NCabbage/e203_cnn/py/my_digit.png

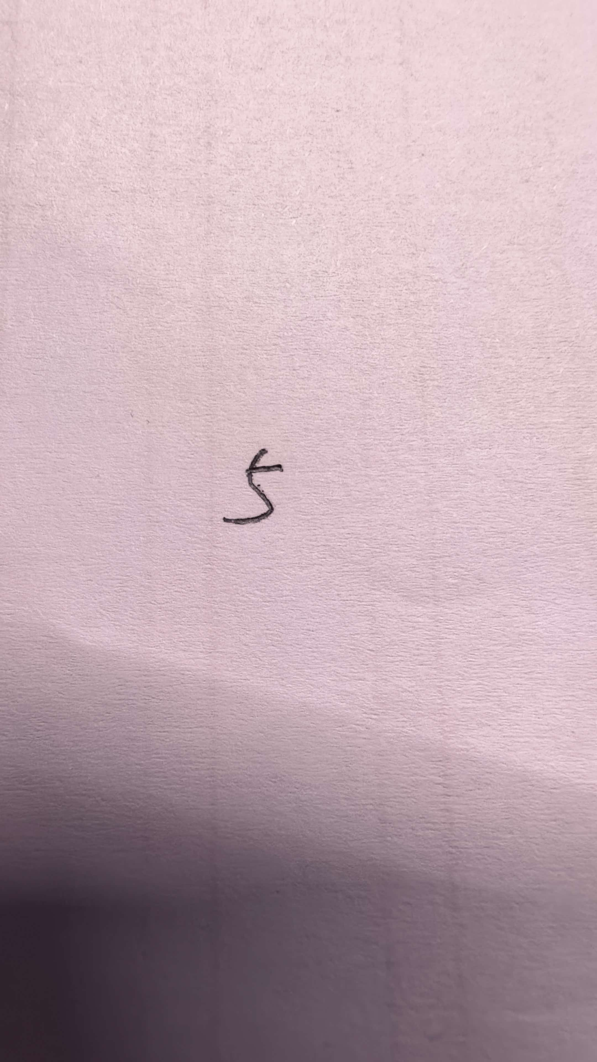
py/my_digit.png
