NCabbage/e203_cnn/测试数据/数据.docx

E203底座:

Coremark分数

HummingBird SDK Build Time: Sep 23 2026, 09:10:42

Download Mode: ILM

CPU Frequency 15936716 Hz

Start to run coremark for 500 iterations

2K performance run parameters for coremark.

CoreMark Size : 666

Total ticks : 236054487

Total time (secs): 14.812167

Iterations/Sec : 33.756034

Iterations : 500

Compiler version : GCC10.1.0

Compiler flags : -O2 -funroll-all-loops -finline-limit=600 -ftree-dominator-opts -fno-if-conversion2 -fselective-scheduling -fno-code-hoisting -fno-common -funroll-loops -finline-functions -falign-functions=4 -falign-jumps=4 -falign-loops=4

Memory location : STACK

seedcrc : 0xe9f5

[0]crclist : 0xe714

[0]crcmatrix : 0x1fd7

[0]crcstate : 0x8e3a

[0]crcfinal : 0xa14c

Correct operation validated. See readme.txt for run and reporting rules.

CoreMark 1.0 : 33.756034 / GCC10.1.0 -O2 -funroll-all-loops -finline-limit=600 -ftree-dominator-opts -fno-if-conversion2 -fselective-scheduling -fno-code-hoisting -fno-common -funroll-loops -finline-functions -falign-functions=4 -falign-jumps=4 -falign-loops=4 / STACK

Print Personal Added Addtional Info to Easy Visual Analysis

(Iterations is: 500

(total_ticks is: 236054487

(*) Assume the core running at 1 MHz

So the CoreMark/MHz can be caculated by:

(Iterations*1000000/total_ticks) = 2.118155 CoreMark/MHz

ICB桥

基线

PS端RAM核数据

耗时0.327ms

E203 跑纯C

===== Benchmark Result =====

Total cycles: 8040143

Total mul num: 282429

Total load num: 639234

Total store num: 66842

Total stall num: 499400

CPU Frequency: 15940321 Hz

Total time: 504 ms

===== Benchmark Done =====

E203+cnn加速器(卷积加速)

===== Benchmark Result =====

Total cycles: 1531035

Total mul num: 829

Total load num: 179109

Total store num: 128768

Total stall num: 866896

CPU Frequency: 15936716 Hz

Total time: 96 ms

===== Benchmark Done =====

纯C基线：504 ms，stall 占比 6.2%，mul 28.2 万次。
e203+cnn加速器：96 ms，加速 5.25 倍，mul 卸载 99.7%，但 store +93%，stall 占比升至 56.6%，平均每次访存 stall 从 0.71 拍升至 2.82 拍。

原因:Stroe增多是因为要往加速器写权重偏置等,stall多是因为走 Mem 总线 → ICB → AXI-Lite → cnn_regs延迟高了,要等.纯C访问的是内部 SRAM / ITCM / DTCM，延迟低
结论：计算卸载成功，瓶颈已从计算转移到 CPU 通过 MMIO 搬运数据。下一步优化聚焦权重预加载与批量传输。

指标 | 纯 C | E203+CNN 加速器 | 变化
Total cycles | 8,040,143 | 1,531,035 | -81%
Total time | 504 ms | 96 ms | -81%
mul | 282,429 | 829 | -99.7%
load | 639,234 | 179,109 | -72%
store | 66,842 | 128,768 | +93%
stall | 499,400 | 866,896 | +74%

指标 | 纯 C | 加速器
stall / total cycles | 499,400 / 8,040,143 ≈ 6.2% | 866,896 / 1,531,035 ≈ 56.6%
每次访存平均 stall | 499,400 / (639,234+66,842) ≈ 0.71 拍 | 866,896 / (179,109+128,768) ≈ 2.82 拍

把权重放到BRAM

===== Benchmark Result =====

Total cycles: 783416

PMU MAC=73514 WLOAD=73514 XLOAD=2108 BUBBLE=4480 TOTAL=82907 AXIWR=7068

Total mul num: 10

Total load num: 24968

Total store num: 18790

Total stall num: 151411

CPU Frequency: 15940321 Hz

Total time: 49 ms

===== Benchmark Done =====

加了多通道池化加速器

===== Benchmark Result =====

Total cycles: 353529

PMU MAC=74634 WLOAD=74634 XLOAD=6588 BUBBLE=4480 TOTAL=86269 AXIWR=12678

Total mul num: 10

Total load num: 22733

Total store num: 20737

Total stall num: 195026

CPU Frequency: 15937372 Hz

Total time: 22 ms

===== Benchmark Done =====

紧耦合

===== Benchmark Result =====

Total cycles: 353028

PMU MAC=74634 WLOAD=74634 XLOAD=6588 BUBBLE=4480 TOTAL=86269 AXIWR=12664

Total mul num: 10

Total load num: 14901

Total store num: 20723

Total stall num: 222802

CPU Frequency: 15939338 Hz

Total time: 22 ms

===== Benchmark Done =====

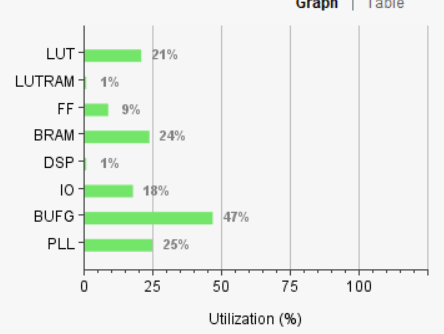
[picture p2: figure]

准确率计算

100图测试

#define QUANT_SHIFT 12

===== Batch Result =====

Total: 100

Correct: 8

Accuracy: 8.00%

Avg cycles: 307772

#define QUANT_SHIFT 11

===== Batch Result =====

Total: 100

Correct: 8

Accuracy: 8.00%

Avg cycles: 307822

#define QUANT_SHIFT 10

===== Batch Result =====

Total: 100

Correct: 98

Accuracy: 98.00%

Avg cycles: 307849

#define QUANT_SHIFT 9

===== Batch Result =====

Total: 100

Correct: 100

Accuracy: 100.00%

Avg cycles: 307861

#define QUANT_SHIFT 8

===== Batch Result =====

Total: 100

Correct: 94

Accuracy: 94.00%

Avg cycles: 307855

1000图测试

#define QUANT_SHIFT 9

===== Batch Result =====

Total: 1000

Correct: 989

Accuracy: 98.90%

Avg cycles: 307863

#define QUANT_SHIFT 8

===== Batch Result =====

Total: 1000

Correct: 913

Accuracy: 91.30%

Avg cycles: 307856

最终测试结果

===== Batch Result =====

Total: 1000

Correct: 989

Accuracy: 98.90%

Avg cycles: 308284
