NCabbage/e203_cnn/docs/README.md

# docs —— 协作同步与移植文档

本目录放**同步说明**和**移植方式**。代码改动在 `rtl/`、`python/`、软件工程里；
**为什么改、怎么搬、要注意什么**放在这里，避免下次交接时靠回忆。

---

## 命名约定（先读这条）

| 代号 | 是谁 | 板卡 | 芯片 |
|---|---|---|---|
| **A** | 同学 | **征服者7020 / AX7020** | XC7Z020-1CLG400C |
| **B** | 我 | **PYNQ-Z2** | XC7Z020-1CLG400C |

> 2026-09-29 前后的早期文档里 A/B 与上表**相反**（当时按"谁的板"分：A=PYNQ-Z2）。
> 看到旧文档请先看日期，一律以本表为准。

---

## 目录说明

| 目录 | 放什么 | 什么时候更新 |
|---|---|---|
| `porting/` | 移植方式：双板差异规范、接口契约、逐步移植步骤 | 跨板搬运方式有变化时 |
| `sync/` | 每次同步说明：推了什么、对方要做什么、什么数字不能采信 | 每次 push 之后 |
| `reports/` | 技术与验证报告：实测数据、优化前后对比、仿真/上板证据 | 完成一个任务节点时 |

---

## 三条硬规则

**1. 共用区改动要通知对方，且不许出现板级信息**

共用区：`rtl/cnn`、`rtl/core`、`rtl/subsys`、`rtl/general`、`rtl/axi_lite_slave`、`python/`、软件工程。
里面不许出现：引脚名、板名、时钟频率常数、按键极性。

**2. 板专属区各留一份，永不互相覆盖**

| 项 | A（AX7020） | B（PYNQ-Z2） |
|---|---|---|
| 顶层复位 | `assign ck_rst = mcu_rst;` | `assign ck_rst = ~mcu_rst;` |
| PL 输入时钟 | H16 = 50 MHz | H16 = 125 MHz |
| 内核时钟 | 16 MHz | 16 MHz |
| 其他 | XDC、PLL `.xci` 各一份 | 同左 |

**3. 实测数据不跨板采信**

- RTL 功能与仿真结论：板无关，可互通
- 上板性能数字（周期、耗时、资源、时序）：**必须各自重测**

---

## 一次同步的标准流程

1. 改完 → 本地跑通（仿真 + 上板）
2. 在 `sync/` 写一份 `YYYY-MM-DD_<commit>_同步说明.md`，必须包含：
   - 推了什么（文件清单，标出共用 / 板专属）
   - 对方**必须**做什么（改哪一行、要不要重新综合或重编 ELF）
   - 哪些数字**不能**采信（单板口径）
3. `git add` **指定文件**（不要 `git add .`，避免把 `.o/.elf/.map` 等构建产物提交）
4. push，然后通知对方

---

## 当前最新同步

- `sync/2026-10-15_加餐1_池化模块_同步说明.md`
  新增 2×2 max pooling（`CFG1[20]=1`）。**`cnn_top.v` 与 `cnn_regs.v` 必须成对同步**，只更一个会端口不匹配。
- `sync/2026-10-12_659f40d_同步说明.md`
  BRAM 权重的**预取时序修复**（`rtl/cnn/cnn_top.v`，**A 侧必须同步**）+ PMU 日志解析工具

技术支撑报告：

- `reports/2026-10-15_加餐1_池化模块.md`
- `reports/2026-10-12_任务6_PMU解析与BRAM前后对比.md`

---

## 已知待处理

- 仓库里的 `rtl/aic_rv32.v` 目前是 **AX7020 的顶层**
  （`ck_rst = mcu_rst`、`.CLK_I_50M(clk)`、`.hfxoscen()` 悬空、LED 注释是 T12/U12/V12/W13），
  却放在共用 `rtl/` 下被跟踪。B 侧误用会直接导致板子起不来。
  建议按 `porting/00_双板差异规范.md` 第三节挪到 `board/ax7020/`，
  或至少在文件头加"AX7020 专用，PYNQ-Z2 勿用"的标注。
