NCabbage/e203_cnn/docs/reports/2026-11-02_比赛设计报告/README.md

# 比赛设计报告（公开脱敏版）

本目录保存比赛设计报告的公开版本。Word 版用于继续编辑，PDF 版用于直接阅读和归档。

## 文件

| 文件 | 说明 |
|---|---|
| `设计报告_脱敏版.docx` | 可编辑 Word 版本，33 页 |
| `设计报告_脱敏版.pdf` | 只读归档版本，33 页 A4 |

## 脱敏范围

公开版本仅处理了身份和审阅信息：

- 参赛队名替换为“匿名参赛队”；
- 学校、队员和指导教师字段替换为“（已脱敏）”；
- 移除 Word 批注、批注范围和批注关系；
- 文档作者和最后修改者改为“匿名参赛队”；
- 正文、图表、实验数据和技术结论保持不变。

原始设计报告未上传，也未修改。

## 校验信息

```text
DOCX SHA256: 59CDDBB33DFE98ABCF2187A77E81CADD685C481721BBD1D4E7EC105CE27ECACB
PDF  SHA256: 964F926F1DBCC05CD915227A5DFB052B9B2DD671C8DB113713EA9BFA3C1E7C3B
页数: 33
页面尺寸: A4
```

## 数据口径

设计报告用于说明系统方案、设计过程和实验分析。需要核对原始数字时，以以下证据为准：

- [`../2026-10-30_第八章复现验证/README.md`](../2026-10-30_第八章复现验证/README.md)
- [`../2026-10-30_第八章复现验证/batch_result.csv`](../2026-10-30_第八章复现验证/batch_result.csv)
- [`../2026-10-30_第八章复现验证/board_selftest.log`](../2026-10-30_第八章复现验证/board_selftest.log)
- [`../2026-10-30_第八章复现验证/timing_summary.txt`](../2026-10-30_第八章复现验证/timing_summary.txt)

报告不同章节可能对应不同实现快照。复现验收中的最新时序原始记录为：

```text
WNS = 0.000000 ns
WHS = -0.025547 ns
```

因此，功能与批测结果可以引用报告和原始日志；严格时序结论应以最新 `timing_summary.txt` 为准，不能把不同快照的数字混合使用。
