NCabbage/e203_cnn/docs/reports/2026-10-15_加餐1_池化模块.md

# 收尾加餐① ：2×2 max pooling 模块

日期：2026-10-15
负责人：B
对应任务表条目：收尾加餐序 8「池化模块（2x2 max）」，1.0 人天　**状态：已完成**
任务表原话："在 baseline 稳定基础上加入 2x2 max pooling 模块 + TB + 资源/时序对比，性价比最高的一天"

---

## 一、设计（最小改动、零风险）

复用 `CFG1` 的空闲位 **[20]** 作为池化开关，MAC 处把"累加"换成"取最大"：

```verilog
acc <= cfg_pool ? ((acc > pool_max32) ? acc : pool_max32)   // 池化：取最大
                : (acc + acc_sum);                          // 卷积：累加
```

配置成 `K=2, STRIDE=2, SHIFT=0, RELU=0, POOL=1` 就是标准 2×2 max pooling。
`cfg_pool=0` 时路径与原来完全一致（回归实测 cycles 一个没变）。

池化模式的三个要点：
1. `bias` 硬件置 0（池化不应叠加偏置）
2. `acc` 初值取 `-32'sd128`（int8 最小值），避免全负窗口被 0 污染
3. 无效 lane（padding 越界）按 `8'sh80`（-128）参与 max，不参与则不改变结果

## 二、RTL 改动

| 文件 | 改动 |
|---|---|
| `rtl/cnn/cnn_top.v` | 新增 `cfg_pool` 端口；池化最大逻辑（7 行）；`acc` 更新二选一；`bias` 池化置 0 |
| `rtl/cnn/cnn_regs.v` | 新增 `cfg_pool` 寄存器，映射到 `CFG1[20]`，例化接线 |

## 三、仿真验证

`sim\run\run_all.ps1`：**7 PASS / 0 FAIL**

| 用例 | 参数 | 结果 | 拍数 |
|---|---|---|---|
| t1_tiny | 卷积 baseline | PASS | 22 |
| t2_stride2 | 卷积 baseline | PASS | 22 |
| t3_saturate | 卷积 baseline | PASS | 22 |
| t4_multi | 卷积 baseline | PASS | 128 |
| t5_requant | 卷积 baseline | PASS | 226 |
| t6_edge | 卷积 baseline | PASS | 22 |
| **t8_pool** | **6×6×1, K=2, S=2, POOL=1** | **PASS** | **29** |

池化用例逐点结果（含负数，验证 max 的符号处理）：

```text
y[0] = -2  (窗口 [-5,-2;-7,-8] 的最大值)
y[1] = 10   y[2] = 11   y[3] = 19   y[4] = 22
y[5] = 24   y[6] = 31   y[7] = 34   y[8] = 36
PMU: MAC=18 WLOAD=0 XLOAD=36 BUBBLE=0 TOTAL=28
```

`BUBBLE=0`：K=2/C=1 的 4 个 tap 正好一拍装满 4-lane，无气泡。

`sim\run_w3\run_w3.ps1`（CPU→ICB→AXI-Lite→CNN）：**PASS**（`cfg_pool=0` 路径未受影响）。

`sim\bram_check`：`xvlog` / `xelab` 均 0 错误。

## 四、综合与实现（PYNQ-Z2 / xc7z020clg400-1）

| 项 | 加池化前 | 加池化后 | 增量 |
|---|---:|---:|---:|
| Slice LUTs | 15,806 (29.71%) | **15,904 (29.89%)** | +98 (+0.18 pp) |
| Slice Registers | 10,229 (9.61%) | 10,237 (9.62%) | +8 |
| Block RAM | 49 (35.00%) | 49 (35.00%) | 0 |
| DSP | 16 | 16 | 0 |
| WNS / WHS | 0.000 / 0.023 | **0.000 / 0.028** | 时序满足 |

结论：池化只多花 **98 个 LUT + 8 个 FF**，BRAM/DSP 零增加，时序仍然收敛。

实现策略：Explore（OPT / PLACE / PHYS_OPT / ROUTE）。

## 五、使用方法

```c
/* 2x2 max pooling：H×W×1 -> (H/2)×(W/2)×1 */
CNN_WR(CNN_CFG0, cnn_cfg0(H, W, 1, 2));              /* C=1, K=2 */
CNN_WR(CNN_CFG1, cnn_cfg1(1, 2, 0, 0, 0) | (1u << 20));  /* OC=1, S=2, POOL=1 */
cnn_load_input(x, H * W);
cnn_run();
for (int i = 0; i < (H/2)*(W/2); i++) y[i] = cnn_read_output(i);
```

多通道池化：逐通道调用（每次 `C=1`），因为硬件一次只处理单通道的 K×K 窗口。

## 六、上板验证（PYNQ-Z2，2026-10-15）

bitstream 烧录 + 串口实测：

```text
===== Benchmark Result =====
Total cycles: 864477
PMU MAC=78208 WLOAD=0 XLOAD=2108 BUBBLE=4480 TOTAL=82907 AXIWR=7068
Total time: 54 ms

===== Pooling Selftest (2x2 max) =====
  pool[0] = -2  (expect -2)
  pool[1] = 10  (expect 10)
  pool[2] = 11  (expect 11)
  pool[3] = 19  (expect 19)
  pool[4] = 22  (expect 22)
  pool[5] = 24  (expect 24)
  pool[6] = 31  (expect 31)
  pool[7] = 34  (expect 34)
  pool[8] = 36  (expect 36)
POOL SELFTEST: PASS
```

**9/9 与黄金模型一致**（含负数窗口 `pool[0] = -2`）。

同时确认池化改动**没有影响原有卷积路径**：
- LeNet 预测仍为 `class = 5`（正确）
- PMU 数据与加池化前逐项相同（`MAC=78208 WLOAD=0 XLOAD=2108 BUBBLE=4480 TOTAL=82907 AXIWR=7068`）

原始日志：`report\POOL_board_uart_20261015.txt`

## 七、下一步

- 上板补测池化自检结果
- 收尾加餐序 9：FC 硬件复用（转 1×1 卷积）/ Sobel 彩蛋（1.5 人天）
