NCabbage/e203_cnn/docs/reports/2026-10-12_任务6_PMU解析与BRAM前后对比.md

# 任务 6（表内 4-3）：PMU / CSR 日志解析脚本

日期：2026-10-12（2026-10-12 修订）
负责人：B
对应任务表条目：第一梯队第 6 项「PMU 日志解析脚本（4-3）」，0.5 人天

---

## 零、修订说明（重要）

本文档 2026-10-12 做了两处纠正：

1. **权重 BRAM 的实现方是 A 侧**。B 侧的贡献是：发现并修复 BRAM 版权重同步读的预取时序 bug
   （`(tcnt+4)>>2` → `(tcnt+8)>>2`，否则 C3/C5 这类多输出通道层从第 3 组 tap 起读错权重）、
   仿真 TB 适配、6 用例回归、逐层 JTAG 比对、以及优化前后的量化对比。
2. **CSR 之前的对比数据口径不可靠，已撤回**。详见第五节。

---

## 一、交付物

| 文件 | 说明 |
|---|---|
| `python\pmu\pmu_report.py` | 解析 + 出图主脚本 |
| `python\pmu\README.md` | 用法说明、三种输入格式、口径说明 |
| `report\pmu_out\pmu_summary.csv` | 每条记录一行（原始 + 派生指标） |
| `report\pmu_out\pmu_report.md` | 自动生成的报告 |
| `report\pmu_out\fig_pmu_*.png` | PMU_TOTAL 构成饼图 + lane 利用率饼图 |
| `report\pmu_out\fig_compare.png` | 多记录四联对比图 |

## 二、解析能力（三种输入，均已用真实日志验证）

1. 上板串口日志：`Total cycles:` / `Total mul num:` / `PMU MAC=...` 行
2. OpenOCD 读寄存器：`0x40000030: 00010000 00000001 ...`
3. 人工整理表格：`0x40000038 PMU_MAC 0x00011f2a 73514`

交叉验证：同一次 10-09 上板运行，用「JTAG 寄存器」和「人工表格」两种格式解析，
得到的 6 个 PMU 值完全一致（73514 / 44190 / 2996 / 4480 / 78217 / 52161）。

## 三、串口与 JTAG 双通路验证（2026-10-12）

`main.c` 增加 PMU 打印后，串口实测输出：

```text
Predicted class: 5
Total cycles: 865031
PMU MAC=78208 WLOAD=0 XLOAD=2108 BUBBLE=4480 TOTAL=82907 AXIWR=7068
Total time: 54 ms
```

同一版本固件用 JTAG 直读 `0x40000030`：

```text
0x40000030: 00010000 00000001 00013180 00000000 0000083c 00001180 000143db 00001b9c
```

两路数值完全一致 → 串口通路与 JTAG 通路互相印证。

## 四、数据可信度分级（关键）

| 数据 | 口径 | 可信度 |
|---|---|---|
| `PMU_MAC/WLOAD/XLOAD/BUBBLE/TOTAL/AXIWR` | 每次推理前由 `PMU_CTRL` 清计数 | ✅ 单次口径，可直接做前后对比 |
| `cycles` | `t_end - t_start` 差值 | ✅ 单次口径 |
| `mul/load/store/stall` | 2026-10-12 起改为运行前后差值 | ✅ 单次口径（本次新增） |
| `mul/load/store/stall`（10-09、10-11 的旧记录） | 自复位以来累计，**未清零** | ❌ 不可用于前后对比 |

原因：A 侧 CSR（`0xCC0-0xCC3`）只实现了读通路
（`sel_mulcnt = (csr_idx==12'hcc0)` 仅接 `csr_rd_en`），计数器只在 MUL/LD/ST 时自增，
**没有写清零通路**，`csr_clear_*()` 是空操作。加载 ELF 不复位 CPU，因此多次运行会累加。

## 五、权重 BRAM 优化前后对比（只保留可靠口径）

### 5.1 PMU：可靠（单次口径）

| 指标 | 优化前 2026-10-09 | 优化后 2026-10-12 | 变化 |
|---|---:|---:|---:|
| `PMU_WLOAD` 权重装载周期 | 44,190 | **0** | **−100%** |
| `PMU_AXIWR` AXI-Lite 写事务 | 52,161 | **7,068** | **−86.4%** |
| `PMU_XLOAD` 输入装载周期 | 2,996 | 2,108 | −29.6% |
| `PMU_MAC` | 73,514 | 78,208 | +6.4% |
| `PMU_TOTAL` | 78,217 | 82,907 | +6.0% |
| MAC lane 利用率 | 93.91% | 94.27% | +0.36 pp |
| 端到端 cycles | 1,489,638 | **865,031** | **−41.9%** |
| 端到端耗时 | 93 ms | **54 ms** | **−41.9%** |

注：`PMU_MAC/TOTAL` 上升约 6% 来自两版固件的层分块策略差异（10-11 的 W_DEPTH 分块兼容改动），
不是 BRAM 优化引入的；`WLOAD=0` 是权重固化到 BRAM 的直接证据。

### 5.2 CSR：单次口径（2026-10-12 新测，两次运行完全一致）

| 指标 | BRAM 版单次值 |
|---|---:|
| `mul` | 10 |
| `load` | 34,114 |
| `store` | 19,260 |
| `stall` | 202,746 |

**已撤回**：此前用 10-09 的 `824/179582/129415/829897` 与 10-11 的 `799/99669/38752/487532`
做差，两者都是不同轮数的累计值，相减没有意义。

若要补齐「优化前的 CSR 单次值」，需要回退到优化前固件重跑一次，或请 A 侧为 CSR 增加写清零通路。

## 六、上板记录

- bitstream：`e203_zynq\prj\e203_zynq.runs\impl_1\aic_rv32.bit`（BRAM 版，WNS 0.000 / WHS 0.008）
- ELF：`LeNet_oneP.elf`（2026-10-12 11:24，含 PMU 打印 + CSR 差值口径）
- 串口复现（两次，结果一致）：
  - `report\PMU_print_board_uart_bram_weights_20261012b.txt`
  - `report\PMU_print_board_uart_bram_weights_20261012c.txt`
- JTAG 寄存器：`report\PMU_board_regs_bram_weights_20261012.txt`

## 七、给 A 侧的两条建议

1. `rtl/cnn/cnn_top.v` 的 `(tcnt + 32'd8) >> 2` 修复必须同步，否则多输出通道层权重错位。
2. CSR（`0xCC0-0xCC3`）建议补写清零通路（`csr_wr_en & sel_xxx` 时清零计数器），
   否则每次测量都必须靠软件取差值，批量测试脚本也要跟着做差值。

## 八、下一步

- 任务 7 的优化前后对比已有可靠数据（第 5.1 节）
- 待办：`4-2 串口批量测试脚本`（1.0 天，串口通路已验证可用）、`加餐① 池化`（1.0 天）
