NCabbage/e203_cnn/docs/sync/2026-10-15_加餐1_池化模块_同步说明.md

# 同步说明：收尾加餐① 2×2 max pooling

- 日期：2026-10-15
- 方向：B（PYNQ-Z2）→ A（征服者7020）
- 板级属性：**全部为共用区改动**

## 一、这次推了什么

| 文件 | 变更 | 分类 | A 侧要不要动 |
|---|---|---|---|
| `rtl/cnn/cnn_top.v` | 新增 `cfg_pool` 端口 + 池化取最大逻辑 | 共用 | ✅ **必须同步** |
| `rtl/cnn/cnn_regs.v` | 新增 `cfg_pool` 寄存器，映射 `CFG1[20]` | 共用 | ✅ **必须同步** |
| `python/golden/export_hex.py` | 新增 `maxpool2d_int8()` 与 `t8_pool` 用例 | 共用 | 可选 |
| `docs/reports/2026-10-15_加餐1_池化模块.md` | 交付文档 | 文档 | 参考 |

> **`cnn_top.v` 与 `cnn_regs.v` 必须成对同步**：前者加了 `cfg_pool` 端口，
> 后者才提供该端口的例化接线。只更新其中一个会导致端口不匹配、综合直接失败。

## 二、功能与用法

`CFG1[20] = 1` 进入池化模式：MAC 处由"累加"改为"取最大值"。

```c
CNN_WR(CNN_CFG0, cnn_cfg0(H, W, 1, 2));                  /* C=1, K=2 */
CNN_WR(CNN_CFG1, cnn_cfg1(1, 2, 0, 0, 0) | (1u << 20));  /* POOL=1, S=2, SHIFT=0, RELU=0 */
cnn_load_input(x, H * W);
cnn_run();
```

`cfg_pool = 0` 时行为与原来**完全一致**（回归实测 6 个卷积用例的 cycles 一个没变）。

## 三、验证结果（B 侧）

| 项 | 结果 |
|---|---|
| 单元回归 | 7 PASS / 0 FAIL（原 6 个 + 新增 `t8_pool`） |
| 池化上板 | 9/9 与黄金模型一致，`POOL SELFTEST: PASS`，含负数窗口 |
| W3 联合验证 | PASS |
| 综合/实现/时序 | WNS 0.000 / WHS 0.028，约束满足 |
| 资源增量 | +98 LUT、+8 FF，BRAM/DSP **零增加** |
| 对原路径影响 | LeNet 预测仍为 class 5，PMU 数据与加池化前逐项相同 |

## 四、A 侧不要直接采信的

| 类别 | 能否采信 |
|---|---|
| RTL 功能与仿真结论（7 用例 PASS、上板 9/9 一致） | ✅ 板无关，可采信 |
| 资源增量（+98 LUT / +8 FF） | ⚠️ 同芯片同频率，可参考；PLL IP 不同略有差异 |
| 上板性能数字（cycles 864477、54 ms） | ❌ PYNQ-Z2 专属，需自行重测 |

## 五、A 侧要做的事

1. `git pull origin main`
2. 确认 `rtl/cnn/cnn_top.v` 和 `rtl/cnn/cnn_regs.v` **两个都更新**
3. 重新综合 → 实现 → 生成 bitstream
4. 如果也要用池化：`CFG1[20] = 1`，配 `K=2/S=2/SHIFT=0/RELU=0`
5. 板级文件（`aic_rv32.v` / XDC / PLL）保持各留各的，本次未涉及

## 六、下一位要接的话

收尾加餐序 9：FC 硬件复用（转 1×1 卷积）/ Sobel 彩蛋（1.5 人天，B 负责）。
