NCabbage/e203_cnn/docs/porting/01_移植方案_桥接进B侧工程.md

# 把 A 同学（总线桥）的改动移植进你的 Vivado 工程

- 你的工程（目标）：`D:\HuaweiMoveData\Users\xiaoyu zheng\Desktop\e203_zynq`
- 同学仓库（来源）：`D:\fpgafile\e203_cnn`（github.com/NCabbage/e203_cnn）
- 对比日期：2026-09-29

---

## 一、结论（先看这个）

**要移植的东西非常少，只有 3 处。** 逐文件哈希对比结果：

| 类别 | 文件 | 说明 |
|---|---|---|
| 新增 | `rtl/axi_lite_slave/Axi4_lite_slave.v` | AXI4-Lite 从机（同学写的/借的） |
| 新增 | `rtl/axi_lite_slave/regfile.v` | 16x32 测试寄存器堆（占位用） |
| 改动 | `rtl/subsys/e203_subsys_mems.v` | 把示例从机 `sirv_expl_axi_slv` 换成上面这两个 |

**其余文件全部相同**（138 个 .v 里只有这 3 个不一样）。

> 注意：同学的 `rtl/aic_rv32.v` **不是他改的**，是他的仓库 fork 得比你早，
> 里面还是旧版：`assign ck_rst = mcu_rst;`（旧的复位极性）、PLL 没走 IBUFG、
> `.hfxoscen()` 没接、还挂着一个 `ila_0`。
> **千万不要用他的 aic_rv32.v 覆盖你的**，否则你会把已经修好的复位极性/时钟链又退回坑里。

---

## 二、移植三个步骤

### 步骤 1：把两个新文件加进 Vivado 工程

在 Vivado 里：`Add Sources` -> 选这两个文件（`New File` 不要勾）
    `<本目录>\rtl_from_teammate\Axi4_lite_slave.v`
    `<本目录>\rtl_from_teammate\regfile.v`

或者用我给你的脚本（推荐，一步到位 + 自动更新编译顺序）：
    `Vivado -mode batch -source <本目录>\scripts\add_cnn_rtl.tcl`

> 建议先按 **03_给A的桥问题清单.md** 修完死锁再综合，否则读写会挂死。

### 步骤 2：改 `e203_subsys_mems.v`

文件：`rtl/subsys/e203_subsys_mems.v`
把第 472~514 行的 `sirv_expl_axi_slv` 实例**整段替换**成
`patch\e203_subsys_mems_替换片段.v` 里的内容（那里有可直接粘贴的最终版）。

替换后在文件开头附近（wire 声明区）确认这几个名字可用：
- `clk`、`bus_rst_n` —— 已经是该模块的输入，OK
- `expl_axi_*` —— 已经是该模块内部 wire，OK

### 步骤 3：综合检查

跑 Synthesis，只要没有：
- `Axi4_lite_slave` / `regfile` 找不到（说明步骤 1 没做）
- 端口位宽不匹配
就说明移植完成了。

**这一步只验证"能编译"，功能要靠 A 的 W2 桥仿真（读写寄存器、无死锁）。**

---

## 三、CNN 外设的地址（B 必须知道）

`e203_subsys_mems.v` 里的 ICB 分叉器地址表（第 121~157 行）：

| 端口 | 地址范围 | 用途 |
|---|---|---|
| O0 | 0x0000_0000 - 0x0000_0FFF | Debug Module |
| O1 | 0x0000_1000 - 0x0000_1FFF | MROM |
| O2 | 0x0002_0000 | 未用 |
| O3 | 0x2000_0000 - 0x3FFF_FFFF | QSPI0-RO |
| O4 | 0x8000_0000 - 0xFFFF_FFFF | SysMem（ITCM/DTCM 等） |
| **O5** | **0x4000_0000 - 0x4FFF_FFFF** | **← 外挂 AXI 外设，CNN 就挂这里** |
| O6/O7 | - | 未用 |

所以：

- CPU 侧基址 = **`0x4000_0000`**，跨 256 MB 的区域（REGION_LSB=28）
- 你之后写驱动就是 `*(volatile uint32_t*)(0x40000000 + offset)`
- 你在 `regfile.v` 里用的 `wr_addr[5:2]` 正好是 16 个字 = 0x40 字节的寄存器空间，
  即偏移 0x00~0x3C，和基址组合后是 0x4000_0000 ~ 0x4000_003C

---

## 四、移植前必读

**同学的桥目前有硬死锁，读写不通（详见 03 号文档）**，原因是：
E203 的 `sirv_gnrl_icb2axi` 用的是"holdup 让行"时序 ——
AWVALID 要等 WREADY、WVALID 要等 AWREADY；
而同学的从机又要求"AWVALID 和 WVALID 同时有效"才给 AWREADY/WREADY。
两边互相等 → 永远卡死。

原厂示例从机 `sirv_expl_axi_slv` 的写法是 `assign axi_awready = 1'b1;`（常高），
就是为绕开这个坑。修复方向见 03 号文档。

---

## 五、验收标准（这段直接抄进你的进度表）

- [ ] `Axi4_lite_slave.v` / `regfile.v` 已加入 Vivado 工程并能综合
- [ ] `e203_subsys_mems.v` 已替换，综合通过
- [ ] A：桥仿真 读寄存器 / 写寄存器 / 无死锁（32 拍内必有响应）
- [ ] B：把 regfile 换成真正的 CNN 寄存器组（见 02 号文档）
- [ ] 联调：CPU 写 0x4000_0000 能读到回写值
