NCabbage/e203_cnn/docs/porting/02_移植到A侧的步骤与接口契约.md

# 把 B 的 CNN 外设移植到 A 侧（AX7020）+ 接口契约

给：A　编写：B　日期：2026-10-03

---

# 第一部分：移植步骤

## 步骤 0 · 先确认你的基线状态

在你的工程里搜一下，确认现在没有原厂示例从机还在接：
```bash
grep -n "sirv_expl_axi_slv" rtl/subsys/e203_subsys_mems.v
```
- **搜到** → 说明你还没把桥接进去，按步骤 3 替换
- **搜不到、且已有 `Axi4_lite_slave`** → 你只差加 `cnn_regs`

## 步骤 1 · 拿到这些文件（**RTL + Python 黄金模型 + 测试向量**）

从共用仓库拉（推荐，保证两边同一份）：
```bash
git pull          # B 已把 rtl/cnn/ 推上去后
```
或直接拷这 4 个文件到你的 `rtl/cnn/`：
```
cnn_top.v      ← CNN 内核主体（4 路 MAC 阵列 + 状态机）
cnn_quant.v    ← 算术右移 + ReLU + 饱和
cnn_mac.v      ← int8 乘 + int32 累加（辅助单元）
cnn_regs.v     ← CNN 寄存器组（你要接的就是它）
```
> 这四个文件是**板无关**的：没有引脚名、没有板名、没有频率常数。
> 你在 AX7020 上直接用，不需要改一行。

**同时还要拿这三样（别漏 —— 详见第二部分第 10 节）：**

| 要拿什么 | 为什么 |
|---|---|
| `python/golden/*.py`（4 个脚本） | **你写 C 卷积的算法唯一参考**，也是你 C 实现的验收判据 |
| `python/data/<用例>/golden.txt` | 人看的输入/权重/期望输出 —— **直接拿来填 C 数组** |
| `python/data/<用例>/*.hex` + `python/README.md` | 机器可读向量 + 数值约定/hex 格式说明 |

> ⚠️ 你 W4 的「纯软件 C 卷积（性能基线）」要求**与硬件位宽对齐**，
> 黄金模型就是那个"位宽/量化/饱和"的标准答案。没有它，
> "软件基线 vs 硬件"的对比在报告里站不住。

## 步骤 2 · 加进你的 Vivado 工程

GUI：`Add Sources` → 选这 4 个文件（不要勾 "Copy sources into project" 除非你要）

Tcl（推荐）：
```tcl
set SRC "D:/你的路径/rtl/cnn"
foreach f [list "$SRC/cnn_top.v" "$SRC/cnn_quant.v" "$SRC/cnn_mac.v" "$SRC/cnn_regs.v"] {
    add_files -norecurse [list $f]      ;# 注意：必须用 [list ...]
}
update_compile_order -fileset sources_1
```
> ⚠️ **路径含空格时必须写成 `add_files -norecurse [list $f]`**。
> 直接 `add_files $f` 会报 `ERROR: [Vivado 12-172] File or Directory '...' does not exist`（实测）。

## 步骤 3 · 改 `e203_subsys_mems.v`（**本次唯一的 RTL 改动**）

找到原来那段：
```verilog
sirv_expl_axi_slv #(
  .AW   (32),
  .DW   (`E203_XLEN)
) u_perips_expl_axi_slv (
    .axi_arvalid (expl_axi_arvalid),
    ...
    .rst_n       (rst_n)
);
```
**整段删掉**，换成下面（你的从机 + B 的寄存器组）：

```verilog
//===========================================================================
// 外挂 AXI 外设（CNN）：ICB2AXI -> AXI4-Lite 从机 -> CNN 寄存器组 -> CNN
//   地址窗口：0x4000_0000 - 0x4FFF_FFFF（ICB 分叉的 O5 端口）
//===========================================================================
wire [31:0]               o_ctrl_wr_addr ;
wire                      o_ctrl_wr_en   ;
wire [`E203_XLEN-1:0]     o_ctrl_wr_data ;
wire [(`E203_XLEN/8)-1:0] o_ctrl_wr_mask ;
wire [31:0]               o_ctrl_rd_addr ;
wire [`E203_XLEN-1:0]     i_ctrl_rd_data ;

Axi4_lite_slave #(
  .AW (32         ),
  .DW (`E203_XLEN )
) u_axi_lite_slave (
  .i_s_axi_aclk    (clk              ),
  .i_s_axi_aresetn (bus_rst_n        ),

  .i_s_axi_awaddr  (expl_axi_awaddr  ),
  .i_s_axi_awprot  (expl_axi_awprot  ),
  .i_s_axi_awvalid (expl_axi_awvalid ),
  .o_s_axi_awready (expl_axi_awready ),

  .i_s_axi_wdata   (expl_axi_wdata   ),
  .i_s_axi_wstrb   (expl_axi_wstrb   ),
  .i_s_axi_wvalid  (expl_axi_wvalid  ),
  .o_s_axi_wready  (expl_axi_wready  ),

  .o_s_axi_bresp   (expl_axi_bresp   ),
  .o_s_axi_bvalid  (expl_axi_bvalid  ),
  .i_s_axi_bready  (expl_axi_bready  ),

  .i_s_axi_araddr  (expl_axi_araddr  ),
  .i_s_axi_arprot  (expl_axi_arprot  ),
  .i_s_axi_arvalid (expl_axi_arvalid ),
  .o_s_axi_arready (expl_axi_arready ),

  .o_s_axi_rdata   (expl_axi_rdata   ),
  .o_s_axi_rresp   (expl_axi_rresp   ),
  .o_s_axi_rvalid  (expl_axi_rvalid  ),
  .i_s_axi_rready  (expl_axi_rready  ),

  .o_ctrl_wr_addr  (o_ctrl_wr_addr   ),
  .o_ctrl_wr_en    (o_ctrl_wr_en     ),
  .o_ctrl_wr_data  (o_ctrl_wr_data   ),
  .o_ctrl_wr_mask  (o_ctrl_wr_mask   ),
  .o_ctrl_rd_addr  (o_ctrl_rd_addr   ),
  .i_ctrl_rd_data  (i_ctrl_rd_data   )
);

//---------------------------------------------------------------------------
// CNN 寄存器组（B 的文件）—— 端口与原 regfile 完全一致
//---------------------------------------------------------------------------
cnn_regs #(
  .AW (32         ),
  .DW (`E203_XLEN )
) u_cnn_regs (
  .clk     (clk            ),
  .rst_n   (bus_rst_n      ),
  .wr_en   (o_ctrl_wr_en   ),
  .wr_addr (o_ctrl_wr_addr ),
  .wr_data (o_ctrl_wr_data ),
  .wr_mask (o_ctrl_wr_mask ),
  .rd_addr (o_ctrl_rd_addr ),
  .rd_data (i_ctrl_rd_data )
);
```

> **如果你原来用的是 `regfile`**：把那个 `regfile ... u_regfile (...)` 实例
> **整个换成 `cnn_regs ... u_cnn_regs (...)`** 即可 —— 端口名一模一样，一根线都不用动。

可选（消一个告警，2 分钟）：你的从机没有 `rlast` 端口，加一行
```verilog
assign expl_axi_rlast = 1'b1;   // 单拍读
```

## 步骤 4 · 绝对不要动的东西（板专属）

| 文件 | 为什么 |
|---|---|
| **`rtl/aic_rv32.v`** | 你的和我的**必须不同**：复位极性（你是 `ck_rst = mcu_rst`，我是 `~mcu_rst`）、IBUFG、`hfxoscen` 接法都不同。**互相覆盖 = 板子起不来** |
| **`xdc/*.xdc`** | 引脚完全不同（你 H16/M17/J19/F19/D19，我 W18/W19/V6/U7） |
| **PLL 的 `.xci`** | 输入频率不同（你 50 MHz 晶振，我 125 MHz 来以太网 PHY）。两边都凑到 16 MHz，但 IP 配置不同 |
| **`rtl/axi_lite_slave/regfile.v`** | 已被 `cnn_regs` 取代，**不在通路上，不用修里面的 latch** |

## 步骤 5 · 综合 → 实现 → 生成 bit

```tcl
reset_run synth_1
launch_runs synth_1 -jobs 4
wait_on_run synth_1
reset_run impl_1
launch_runs impl_1 -to_step write_bitstream -jobs 4
wait_on_run impl_1
puts "SYNTH: [get_property STATUS [get_runs synth_1]]"
puts "IMPL : [get_property STATUS [get_runs impl_1]]"
```
**我这边跑出来的参考值**（同芯片，你的应该接近）：
- LUT 24.3%、FF 9.3%、DSP 20、BRAM 33/140
- WNS 0.000 / WHS −0.105 ns
- 若你报 hold 违例，16 MHz 下一般不影响功能

## 步骤 6 · 上板验证（用你自己的 JTAG / 串口流程）

**不用抄我的下载流程**（你是板载 JTAG，我是外接 FT2232）。只需要：
1. 烧你新生成的 bit
2. 写 C 驱动（见第二部分 5/6 节）
3. 串口打印，先跑 `t1_tiny`，**期望 `[0, 0, 3, 0]`**

**测试数据在这里**：`python/data/t1_tiny/`
- `golden.txt` — 人看的输入/权重/期望输出（照这个填 C 数组）
- `x_w.hex` / `w_w.hex` / `b.hex` — 机器可读
- `meta.txt` — 形状与参数

---

# 第二部分：接口契约（B 承诺提供、A 遵守使用）

## 1. 端口契约（最硬的一条 —— 分界线就在这 8 个信号）

```
module cnn_regs #(parameter AW=32, DW=32) (
    input  wire              clk,        // 与 AXI-Lite 从机同一个时钟
    input  wire              rst_n,      // 与从机同一个复位（低有效）
    input  wire              wr_en,      // 1 拍写脉冲
    input  wire [AW-1:0]     wr_addr,    // 写地址（用低 8 位译码）
    input  wire [DW-1:0]     wr_data,    // 写数据
    input  wire [(DW/8)-1:0] wr_mask,    // 字节掩码
    input  wire [AW-1:0]     rd_addr,    // 组合读地址
    output reg  [DW-1:0]     rd_data     // 组合读数据
);
```

**B 承诺**：这组端口**不会再变**。你要改寄存器行为，改的是 `cnn_regs.v` 内部的
`case (wa)` 分支，端口不动 —— 不动就影响不到你的从机。

**你要做的**：只把从机的 `o_ctrl_*` 接到上面这组信号，别的都不用管。

## 2. 寄存器映射（冻结版）

**基址 `0x4000_0000`**（`e203_subsys_mems.v` 里 ICB 分叉的 O5 端口，窗口 0x4000_0000–0x4FFF_FFFF）

| 偏移 | 名字 | 读写 | 位定义 |
|---|---|---|---|
| 0x00 | CTRL | W | [0]start [1]clr_wptr [2]clr_iptr [3]clr_bptr |
| 0x04 | STATUS | R | [0]busy [1]done |
| 0x08 | WDATA | W | 写一个 int8 权重 → w_mem[wptr++]（低 8 位有效） |
| 0x0C | IDATA | W | 写一个 int8 激活 → x_mem[iptr++] |
| 0x10 | BIAS | W | 写一个 int32 偏置 → b_mem[bptr++] |
| 0x14 | CFG0 | W | H[7:0] W[15:8] C[23:16] K[31:24] |
| 0x18 | CFG1 | W | OC[7:0] STRIDE[9:8] PAD[13:10] SHIFT[18:14] RELU[19] |
| 0x1C | OINDEX | W | 设置要读的输出序号 |
| 0x20 | ODATA | R | 读 y[OINDEX]（int8 符号扩展到 32 位） |
| 0x24 | WPTR | R | 权重写指针（调试） |
| 0x28 | IPTR | R | 输入写指针（调试） |
| 0x2C | YCOUNT | R | 已完成输出个数 |
| 0x30 | VERSION | R | 固定 `0x0001_0000`（联调第一件事就是读它） |

## 3. 数值约定（三方必须一致：RTL / Python / 你的 C）

```
激活 int8 有符号, 权重 int8 有符号, 偏置 int32, 累加 int32
y = (Σ x·w + bias) >>> SHIFT      ← 算术右移（RTL 里就是 >>>）
y = max(y, 0)                     ← ReLU，在右移之后
y = clamp(y, -128, 127)           ← 饱和到 int8
```

## 4. 数据布局（写数据顺序）

```
激活 x : [H][W][C]           地址 = (h*W + w)*C + c
权重 w : [K][K][C][OC]       地址 = ((kh*K + kw)*C + c)*OC + oc
输出 y : [OH][OW][OC]        读序号 = ((oh*OW) + ow)*OC + oc
其中 OH = (H + 2*PAD - K)/STRIDE + 1，OW 同理
```

## 5. `cnn.h`（可直接抄）

```c
#ifndef __CNN_H__
#define __CNN_H__
#include <stdint.h>

#define CNN_BASE     0x40000000UL
#define CNN_CTRL     (CNN_BASE + 0x00)
#define CNN_STATUS   (CNN_BASE + 0x04)
#define CNN_WDATA    (CNN_BASE + 0x08)
#define CNN_IDATA    (CNN_BASE + 0x0C)
#define CNN_BIAS     (CNN_BASE + 0x10)
#define CNN_CFG0     (CNN_BASE + 0x14)
#define CNN_CFG1     (CNN_BASE + 0x18)
#define CNN_OINDEX   (CNN_BASE + 0x1C)
#define CNN_ODATA    (CNN_BASE + 0x20)
#define CNN_WPTR     (CNN_BASE + 0x24)
#define CNN_IPTR     (CNN_BASE + 0x28)
#define CNN_YCOUNT   (CNN_BASE + 0x2C)
#define CNN_VERSION  (CNN_BASE + 0x30)

#define CNN_CTRL_START     (1u<<0)
#define CNN_CTRL_CLR_WPTR  (1u<<1)
#define CNN_CTRL_CLR_IPTR  (1u<<2)
#define CNN_CTRL_CLR_BPTR  (1u<<3)
#define CNN_STATUS_BUSY    (1u<<0)
#define CNN_STATUS_DONE    (1u<<1)

#define CNN_RD(a)   (*(volatile uint32_t *)(a))
#define CNN_WR(a,v) do { (*(volatile uint32_t *)(a)) = (uint32_t)(v); } while (0)

static inline uint32_t cnn_cfg0(uint32_t h,uint32_t w,uint32_t c,uint32_t k){
    return (h&0xFF) | ((w&0xFF)<<8) | ((c&0xFF)<<16) | ((k&0xFF)<<24);
}
static inline uint32_t cnn_cfg1(uint32_t oc,uint32_t stride,uint32_t pad,uint32_t shift,uint32_t relu){
    return (oc&0xFF) | ((stride&3u)<<8) | ((pad&0xFu)<<10) | ((shift&0x1Fu)<<14) | ((relu&1u)<<19);
}
#endif
```

## 6. 驱动时序（照这个顺序，别改）

```
1) 读 VERSION，应 == 0x00010000        ← 第一件事，判断桥通没通
2) 写 CTRL = 0x0E                       ← 清 wptr/iptr/bptr
3) 写 CFG0 = cnn_cfg0(H,W,C,K)
   写 CFG1 = cnn_cfg1(OC,STRIDE,PAD,SHIFT,RELU)
4) 循环写 IDATA  (H*W*C 个)              ← 自动递增
   循环写 WDATA  (K*K*C*OC 个)
   循环写 BIAS   (OC 个)
5) 写 CTRL = 0x01                       ← start
6) 轮询 STATUS 直到 done==1（带超时）
7) 循环 { 写 OINDEX=k; 读 ODATA }        ← 先写序号再读数据
8) 写 CTRL = 0                          ← 必须！否则内核停在 DONE 回不去 IDLE
```

**两个容易踩的点**：
- 读结果是**两步**（写 OINDEX → 读 ODATA），不是自动递增
- 每轮结束**必须写 CTRL=0**，否则下一轮启动不了

## 7. 测试向量（拿来就验）

| 用例 | 规模 | 期望输出 | 用途 |
|---|---|---|---|
| **`t1_tiny`** | 4x4x1 k3 1oc → 4 点 | **`[0,0,3,0]`** | **先跑这个 bring-up** |
| `t4_multi` | 5x5x2 k3x3x2x2 → 18 点 | 见 `golden.txt` | 多通道 |
| `t5_requant` | 6x6x2 shift4 → 32 点 | 见 `golden.txt` | 量化右移 |
| `two_layer` | 8x8x1→6x6x2→4x4x2 | 见 `info.txt` | 权重重载 + 两层连跑 |

数据在 `python/data/<用例>/`，每个用例都有 `golden.txt`（人看）+ hex（机器读）+ `meta.txt`（参数）。

## 8. 冻结承诺 & 变更流程

| 内容 | 状态 |
|---|---|
| `cnn_regs` 的 8 个端口 | 🔒 **冻结**，不会再变 |
| 寄存器映射（13 个） | 🔒 **冻结**。要改必须**三方同步**：RTL + `cnn.h` + Python 黄金模型 |
| 数值约定（int8/int32/`>>>`/ReLU/饱和） | 🔒 冻结 |
| `cnn_top.v` 内部实现 | 🟡 可能优化（并行度、存储器类型），**接口与行为不变** |
| 资源/拍数 | 🟡 会变（优化时会更新报告） |

**你如果要改**：先跟我说一声，我改完 RTL 再同步给你，别自己动 `rtl/cnn/*`。

## 9. 出问题怎么找我（排查顺序）

| 现象 | 先查什么 |
|---|---|
| 读 VERSION 不是 `0x00010000` | 桥有没有接对（`expl_axi_*` 那组信号）、地址是不是 `0x4000_0000` |
| 读任何寄存器都是 `0xDEADBEEF` | `rd_addr` 译码没对（地址低 8 位）、或读地址接错了 |
| STATUS 一直是 0（既不 busy 也不 done） | `cnn_start` 没接上（CTRL 写没生效） |
| 写完数据 WPTR/IPTR 不涨 | `wr_en` 没接、或 `wr_addr` 低 8 位不对 |
| done 一直不来 | CFG 配错了（K > H 或 W 会导致无输出） |
| 结果不对但 done 正常 | 数据布局（x/w 的顺序）或数值约定（shift/relu）对不上 |
| 仿真过、上板不过 | 时钟/复位接法；或字节掩码（你的 `mask_data` latch —— 但那个已不在通路上） |

**最快的定位手段**：像我一样用 JTAG/GDB 直接读写寄存器（
`x/1xw 0x40000030`、`set {unsigned int}0x40000000 = 0xE`），
绕开 C 代码，先确认硬件通路本身是好的。
我这边上板实测的数据记录在 `report/上板验证记录_20260930.txt`。
---

## 10. Python 黄金模型（**数值约定的唯一来源** + A 的验收判据）

> ⚠️ 这一节是后来补的 —— 第一版漏了。**A 的 W4「纯软件 C 卷积」必须要它。**

### 10.1 为什么 A 需要它

| 用途 | 说明 |
|---|---|
| **A1 算法参考** | C 卷积怎么写（int32 累加？什么时候右移？ReLU 放哪？饱和到多少？）—— 黄金模型是标准答案 |
| **A2 验收自己的 C 实现** | 任务表要求软件基线"**与硬件位宽对齐**"。你的 C 输出必须和黄金模型**逐点一致**，否则"软件 vs 硬件"的性能对比不成立 |
| **A3 三方对齐的锚点** | 报告里要写"数据与实测一致"，靠的就是 Python ↔ C ↔ RTL 三者**逐点相等** |

### 10.2 三方一致性关系（这就是报告里那句话的来源）

```
        Python 黄金模型  ←── 数值约定的唯一权威
         ↙          ↘
   逐点一致        逐点一致
      ↙              ↘
   RTL (B)        C 实现 (A)
      ↖              ↗
        ↖          ↗
         硬件上板结果（三者必须都对上）
```

### 10.3 交付给 A 的文件

| 文件 | 用途 |
|---|---|
| `python/golden/int8_conv.py` | **卷积黄金模型**：INT8 卷积 + bias + ReLU + 量化 + 饱和（含 numpy 版与纯 Python 版交叉验证） |
| `python/golden/golden_fc.py` | **全连接 + argmax** 黄金模型（你 W4 的"全连接＋argmax 软件实现"用它对照） |
| `python/golden/export_hex.py` | 生成更多/更大的测试向量 |
| `python/README.md` | 数值约定、hex 格式、用例说明 |
| `python/data/<用例>/golden.txt` | **人看的**输入/权重/期望输出 —— **直接拿来填 C 数组** |
| `python/data/<用例>/*.hex` | 机器可读（TB 用） |
| `python/data/<用例>/meta.txt` | 形状与参数 |

### 10.4 A 的 C 实现必须遵守的（对着黄金模型核）

- [ ] 输入/权重用 `int8_t`（**有符号**，不是 uint8）
- [ ] 累加器用 **`int32_t`**，中途不要截断成 int16
- [ ] 右移：`acc >> shift`（**变量类型必须是有符号** —— C 的有符号右移 = 算术右移，
      和无符号右移结果完全不同；黄金模型里对应 `>>>`）
- [ ] **ReLU 在右移之后**（顺序错了结果就不一样）
- [ ] 输出饱和到 `[-128, 127]`
- [ ] 输出顺序 `((oh*OW)+ow)*OC + oc`（`oc` 最内层）

### 10.5 A 怎么自测（三步，越早越好）

1. **PC 上先跑**：把 `golden.txt` 里的输入/权重抄成数组，跑你的 C 卷积，
   和同一文件里的期望输出比 → **纯软件就验证掉**
2. **上板再跑**：同样的数据下到板子上，串口打印，和 `golden.txt` 比
3. **和 RTL 比**：硬件加速器的输出（读 ODATA）也要和它一致 → **三方对齐才算通**

> 第 1 步在 PC 上就能做完，**不占板子**，这是最省时间的验证顺序。

### 10.6 一句话

> **黄金模型不是"参考资料"，是"验收标准"。**
> 你的 C 卷积、B 的 RTL、板上的硬件，三者的输出必须逐点相等 ——
> 而"相等"的定义就写在 `int8_conv.py` 里。
