NCabbage/e203_cnn/docs/sync/2026-10-12_659f40d_同步说明.md

# 给 A 的同步说明（commit 659f40d）

- 日期：2026-10-12
- 仓库：https://github.com/NCabbage/e203_cnn ，分支 main
- 推送范围：`40f6883 -> 659f40d`

## 一、这次同步了 4 项

| 文件 | 变更 | A 侧要不要动 |
|---|---|---|
| `rtl/cnn/cnn_top.v` | 权重预取 `(tcnt+4)>>2` → `(tcnt+8)>>2` | ✅ **必须同步** |
| `LeNet_oneP/include/cnn.h` | 新增 `CNN_PMU_*` 寄存器宏（0x34–0x50） | ⚠️ 用 LeNet_oneP 才需要 |
| `LeNet_oneP/application/main.c` | 推理前清 PMU 计数并打印 PMU 行；CSR 改差值口径 | ⚠️ 同上 |
| `python/pmu/` | 新增 PMU/CSR 日志解析脚本 | 可选（板无关工具） |

## 二、为什么 `cnn_top.v` 必须同步

权重放在 BRAM 后是**同步读**，比原来 CPU 逐字节写 `w_mem` 多一拍延迟。
原预取公式 `(tcnt+4)>>2` 偏晚一个节拍，导致从第 3 个 tap-group 起读到**上一组**权重。

表现：
- 单输出通道层（如 C1）多数情况凑巧正确，掩盖了问题
- **多输出通道层（C3 16 通道、C5 120 通道）权重整体错位，结果全错**

B 侧证据：
- 修前：`t1_tiny` 的 `y[2]=18`（期望 3）；`t4_multi`、`t5_requant` 大量错位
- 修后：6 个单元用例全 PASS；上板逐层比对 C1/S2/C3/S4/C5/F6/OUT 全部 `mismatch=0`

**如果 A 侧不同步这一行，AX7020 上 C3/C5 会同样读错权重。**

## 三、A 侧同步步骤

```bash
git pull origin main
```

然后：
1. 重新综合 → 实现 → 生成 bitstream（`cnn_top.v` 变了）
2. 如果 A 也用 `LeNet_oneP`：重新编译 ELF（`cnn.h`、`main.c` 变了）
3. 上板重跑，确认预测结果和逐层比对

## 四、板级边界（照旧，不要互相覆盖）

- 你的 `aic_rv32.v`（`ck_rst = mcu_rst`）、`E203_AX7020.xdc`、PLL `.xci` 各留各的
- 仓库里 `rtl/aic_rv32.v` 是你那份（50 MHz 输入、复位低有效），B 侧既没使用也没改动
- 提醒：这个文件放在共用 `rtl/` 下容易被 B 侧误用（复位极性反、时钟按 50 MHz），
  建议按双板规范挪到 `board/ax7020/`，或在文件头加"AX7020 专用，PYNQ-Z2 勿用"的标注

## 五、A 侧不要直接采信我的实测数字

| 类别 | 能否采信 |
|---|---|
| RTL 功能与仿真结论（6 用例 PASS、逐层 mismatch=0） | ✅ 板无关，可采信 |
| 时序/资源（WNS 0.000、LUT 30%、BRAM 35%） | ⚠️ 同芯片同频率，可参考；PLL IP 不同会略有差异 |
| 上板性能数字（AXIWR=7068、cycles=865031、54 ms） | ❌ **PYNQ-Z2 专属**，请在自己板上重测 |

## 六、顺手提一个共用区建议（由你决定）

CSR（`0xCC0-0xCC3`）目前**只有读通路，没有写清零**：

```verilog
wire sel_mulcnt = (csr_idx == 12'hcc0);
wire rd_mulcnt  = sel_mulcnt & csr_rd_en;   // 只有读
wire mulcnt_ena = mul_ena;                  // 只在 MUL 时自增
```

后果：加载 ELF 不复位 CPU，计数器会跨多次运行累加，软件必须自己取差值。
如果 A 侧的批量测试也要读单次值，建议补写清零通路（`csr_wr_en & sel_xxx` 时清零计数器）。

## 七、B 侧这次的上板结论（PYNQ-Z2，仅供了解）

```text
Predicted class: 5   (MNIST digit 5，正确)
Total cycles: 865031
PMU MAC=78208 WLOAD=0 XLOAD=2108 BUBBLE=4480 TOTAL=82907 AXIWR=7068
Total time: 54 ms
C1/S2/C3/S4/C5/F6/OUT 逐层与黄金模型比对：全部 mismatch=0
```
