NCabbage/e203_cnn/py/batch_result.csv

idx | label | pred | cycles
0 | 7 | 7 | 308253
1 | 2 | 2 | 308292
2 | 1 | 1 | 308189
3 | 0 | 0 | 308320
4 | 4 | 4 | 308286
5 | 1 | 1 | 308196
6 | 4 | 4 | 308293
7 | 9 | 9 | 308279
8 | 5 | 5 | 308312
9 | 9 | 9 | 308308
10 | 0 | 0 | 308336
11 | 6 | 6 | 308324
12 | 9 | 9 | 308276
13 | 0 | 0 | 308312
14 | 1 | 1 | 308195
15 | 5 | 5 | 308335
16 | 9 | 9 | 308288
17 | 7 | 7 | 308278
18 | 3 | 3 | 308352
19 | 4 | 4 | 308282
20 | 9 | 9 | 308266
21 | 6 | 6 | 308257
22 | 6 | 6 | 308314
23 | 5 | 5 | 308305
24 | 4 | 4 | 308281
25 | 0 | 0 | 308384
26 | 7 | 7 | 308239
27 | 4 | 4 | 308309
28 | 0 | 0 | 308335
29 | 1 | 1 | 308200
30 | 3 | 3 | 308271
31 | 1 | 1 | 308203
32 | 3 | 3 | 308303
33 | 4 | 4 | 308314
34 | 7 | 7 | 308281
35 | 2 | 2 | 308337
36 | 7 | 7 | 308270
37 | 1 | 1 | 308195
38 | 2 | 2 | 308262
39 | 1 | 1 | 308224
40 | 1 | 1 | 308188
41 | 7 | 7 | 308255
42 | 4 | 4 | 308281
43 | 2 | 2 | 308242
44 | 3 | 3 | 308254
45 | 5 | 5 | 308295
46 | 1 | 1 | 308228
47 | 2 | 2 | 308273
48 | 4 | 4 | 308319
49 | 4 | 4 | 308315
50 | 6 | 6 | 308245
51 | 3 | 3 | 308352
52 | 5 | 5 | 308301
53 | 5 | 5 | 308309
54 | 6 | 6 | 308338
55 | 0 | 0 | 308297
56 | 4 | 4 | 308324
57 | 1 | 1 | 308188
58 | 9 | 9 | 308297
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
