NCabbage/e203_cnn/docs/reports/2026-10-30_第八章复现验证/batch_result.csv

idx | label | pred | cycles
0 | 7 | 7 | 308613
1 | 2 | 2 | 308652
2 | 1 | 1 | 308549
3 | 0 | 0 | 308680
4 | 4 | 4 | 308646
5 | 1 | 1 | 308556
6 | 4 | 4 | 308653
7 | 9 | 9 | 308639
8 | 5 | 5 | 308672
9 | 9 | 9 | 308668
10 | 0 | 0 | 308696
11 | 6 | 6 | 308684
12 | 9 | 9 | 308636
13 | 0 | 0 | 308672
14 | 1 | 1 | 308555
15 | 5 | 5 | 308695
16 | 9 | 9 | 308648
17 | 7 | 7 | 308638
18 | 3 | 3 | 308712
19 | 4 | 4 | 308642
20 | 9 | 9 | 308626
21 | 6 | 6 | 308617
22 | 6 | 6 | 308674
23 | 5 | 5 | 308665
24 | 4 | 4 | 308641
25 | 0 | 0 | 308744
26 | 7 | 7 | 308599
27 | 4 | 4 | 308669
28 | 0 | 0 | 308695
29 | 1 | 1 | 308560
30 | 3 | 3 | 308631
31 | 1 | 1 | 308563
32 | 3 | 3 | 308663
33 | 4 | 4 | 308674
34 | 7 | 7 | 308641
35 | 2 | 2 | 308697
36 | 7 | 7 | 308630
37 | 1 | 1 | 308555
38 | 2 | 2 | 308622
39 | 1 | 1 | 308584
40 | 1 | 1 | 308548
41 | 7 | 7 | 308615
42 | 4 | 4 | 308641
43 | 2 | 2 | 308602
44 | 3 | 3 | 308614
45 | 5 | 5 | 308655
46 | 1 | 1 | 308588
47 | 2 | 2 | 308633
48 | 4 | 4 | 308679
49 | 4 | 4 | 308675
50 | 6 | 6 | 308605
51 | 3 | 3 | 308712
52 | 5 | 5 | 308661
53 | 5 | 5 | 308669
54 | 6 | 6 | 308698
55 | 0 | 0 | 308657
56 | 4 | 4 | 308684
57 | 1 | 1 | 308548
58 | 9 | 9 | 308657
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
