NCabbage/e203_cnn/LeNet_oneP/application/main.c

#include <stdio.h>
#include <stdint.h>
#include "hbird_sdk_soc.h"

#include "../include/csr.h"
#include "../include/cnn.h"
#include "../include/wbase_tap.h"
#include "../include/lenet_weights_hw.h"
#include "../include/mnist_samples.h"

// ============ 网络配置 ============
#define INPUT_H       28
#define INPUT_W       28

#define QUANT_SHIFT   8
#define TEST_DIGIT    3
#define OUT_NUM       10

// ============ 张量尺寸 ============
#define C1_OUT_N      (24 * 24 * 6)    // 3456
#define S2_OUT_N      (12 * 12 * 6)    // 864
#define C3_OUT_N      (8 * 8 * 16)     // 1024
#define S4_OUT_N      (4 * 4 * 16)     // 256
#define C5_OUT_N      120
#define F6_OUT_N      84

// ============ 输入 ============
static int8_t  input_img[INPUT_H][INPUT_W];

// ============ 硬件缓冲（只用两个）============
static int8_t  hw_x[4096];
static int8_t  hw_y[4096];

// ============ 输出 ============
static int32_t final_out[OUT_NUM];

// ============ MNIST 样本查找表 ============
static const unsigned char (* const mnist_table[10])[28] = {
    digit0_mnist, digit1_mnist, digit2_mnist, digit3_mnist, digit4_mnist,
    digit5_mnist, digit6_mnist, digit7_mnist, digit8_mnist, digit9_mnist,
};

// ============ 输入初始化 ============
static void init_input(void) {
    const unsigned char (*src)[28] = mnist_table[TEST_DIGIT];
    for (int i = 0; i < INPUT_H; i++)
        for (int j = 0; j < INPUT_W; j++)
            input_img[i][j] = (int8_t)(src[i][j] * 100 / 255);
}

// ============ Argmax ============
static int argmax(const int32_t *arr, int n) {
    int best = 0;
    for (int i = 1; i < n; i++)
        if (arr[i] > arr[best]) best = i;
    return best;
}

// ============ 主函数 ============
int main(void)
{
    printf("\n===== LeNet-5 INT8 HW Inference (HW Pooling) =====\n");
    printf("Quant shift: %d\n", QUANT_SHIFT);
    printf("Test image: MNIST real digit %d\n", TEST_DIGIT);
    printf("Pooling: 2x2 MAX hardware, multi-channel\n");

    if (cnn_init() != 0) {
        printf("ERROR: CNN VERSION != 0x00010000\n");
        while (1);
    }
    printf("CNN VERSION OK\n");

    init_input();
    printf("Init done.\n");

    CNN_WR(CNN_PMU_CTRL, CNN_PMU_CTRL_CLEAR | CNN_PMU_CTRL_EN);

    uint32_t mul_0   = csr_read_mulcnt();
    uint32_t load_0  = csr_read_loadcnt();
    uint32_t store_0 = csr_read_storecnt();
    uint32_t stall_0 = csr_read_stallcnt();

    uint32_t t_start = get_cycle();

    // ==================== C1 卷积 ====================
    // 输入 28x28x1 -> 输出 24x24x6（hw_y 布局 [oh][ow][oc]）
    for (int i = 0; i < 28 * 28; i++)
        hw_x[i] = input_img[i / 28][i % 28];

    cnn_set_wbase(W_BASE_C1);
    cnn_layer(28, 28, 1, 5, 6, 1, 0, QUANT_SHIFT, 1,
              hw_x, c1_bias, hw_y, C1_OUT_N);

    // ==================== S2 硬件池化 ====================
    // hw_y 布局 [24][24][6]，池化输入要求 [h][w][c]，完全相同，直接拷
    for (int i = 0; i < C1_OUT_N; i++) hw_x[i] = hw_y[i];
    cnn_pool(24, 24, 6, hw_x, hw_y, S2_OUT_N);

    // C3 输入：hw_y 布局 [12][12][6]，直接拷
    for (int i = 0; i < S2_OUT_N; i++) hw_x[i] = hw_y[i];

    // ==================== C3 卷积 ====================
    // 输入 12x12x6 -> 输出 8x8x16
    cnn_set_wbase(W_BASE_C3);
    cnn_layer(12, 12, 6, 5, 16, 1, 0, QUANT_SHIFT, 1,
              hw_x, c3_bias, hw_y, C3_OUT_N);

    // ==================== S4 硬件池化 ====================
    for (int i = 0; i < C3_OUT_N; i++) hw_x[i] = hw_y[i];
    cnn_pool(8, 8, 16, hw_x, hw_y, S4_OUT_N);

    for (int i = 0; i < S4_OUT_N; i++) hw_x[i] = hw_y[i];

    // ==================== C5 卷积 ====================
    // 输入 4x4x16 -> 输出 120
    cnn_set_wbase(W_BASE_C5);
    cnn_layer(4, 4, 16, 4, 120, 1, 0, QUANT_SHIFT, 1,
              hw_x, c5_bias, hw_y, C5_OUT_N);

    for (int i = 0; i < C5_OUT_N; i++) hw_x[i] = hw_y[i];

    // ==================== F6 全连接 ====================
    cnn_set_wbase(W_BASE_F6);
    cnn_layer(1, 1, 120, 1, 84, 1, 0, QUANT_SHIFT, 1,
              hw_x, f6_bias, hw_y, F6_OUT_N);

    for (int i = 0; i < F6_OUT_N; i++) hw_x[i] = hw_y[i];

    // ==================== OUT 全连接 ====================
    cnn_set_wbase(W_BASE_OUT);
    cnn_layer(1, 1, 84, 1, 10, 1, 0, QUANT_SHIFT, 0,
              hw_x, out_bias, hw_y, 10);

    for (int i = 0; i < 10; i++)
        final_out[i] = (int32_t)hw_y[i];

    uint32_t t_end = get_cycle();
    uint32_t cycles = t_end - t_start;

    uint32_t mulcnt   = csr_read_mulcnt()   - mul_0;
    uint32_t loadcnt  = csr_read_loadcnt()  - load_0;
    uint32_t storecnt = csr_read_storecnt() - store_0;
    uint32_t stallcnt = csr_read_stallcnt() - stall_0;

    int pred = argmax(final_out, OUT_NUM);

    printf("\nPredicted class: %d\n", pred);
    printf("Final output scores:\n");
    for (int i = 0; i < OUT_NUM; i++)
        printf("  class[%d] = %d\n", i, (int)final_out[i]);

    printf("\n===== Benchmark Result =====\n");
    printf("Total cycles: %u\n", cycles);
    printf("PMU MAC=%u WLOAD=%u XLOAD=%u BUBBLE=%u TOTAL=%u AXIWR=%u\n",
           (unsigned)CNN_RD(CNN_PMU_MAC),
           (unsigned)CNN_RD(CNN_PMU_WLOAD),
           (unsigned)CNN_RD(CNN_PMU_XLOAD),
           (unsigned)CNN_RD(CNN_PMU_BUBBLE),
           (unsigned)CNN_RD(CNN_PMU_TOTAL),
           (unsigned)CNN_RD(CNN_PMU_AXIWR));
    printf("Total mul num: %u\n", mulcnt);
    printf("Total load num: %u\n", loadcnt);
    printf("Total store num: %u\n", storecnt);
    printf("Total stall num: %u\n", stallcnt);
    printf("CPU Frequency: %u Hz\n", (uint32_t)SystemCoreClock);

    if (SystemCoreClock > 0) {
        uint32_t ms = (uint32_t)((uint64_t)cycles * 1000ULL / SystemCoreClock);
        printf("Total time: %u ms\n", ms);
    }
    printf("===== Benchmark Done =====\n\n");

    // ==================== 池化自检 ====================
    printf("===== Pooling Selftest =====\n");
    {
        static const int8_t pool_in[36] = {
            -5, -2,  3,  4, -5,  6,
            -7, -8, -9, 10, 11,-12,
           -13, 14, 15,-16, 17, 18,
            19,-20, 21, 22,-23, 24,
            25, 26,-27, 28, 29,-30,
            31,-32, 33, 34,-35, 36
        };
        static const int8_t pool_exp[9] = { -2, 10, 11, 19, 22, 24, 31, 34, 36 };
        int pool_ok = 1;
        cnn_clear_ptrs();
        CNN_WR(CNN_CFG0, cnn_cfg0(6, 6, 1, 2));
        CNN_WR(CNN_CFG1, cnn_cfg1(1, 2, 0, 0, 0) | (1u << 20));
        cnn_load_input(pool_in, 36);
        cnn_run();
        for (int i = 0; i < 9; i++) {
            int v = (int)cnn_read_output(i);
            printf("  pool[%d] = %d (expect %d)%s\n", i, v, (int)pool_exp[i],
                   (v == (int)pool_exp[i]) ? "" : "  <-- MISMATCH");
            if (v != (int)pool_exp[i]) pool_ok = 0;
        }
        printf("POOL SELFTEST: %s\n", pool_ok ? "PASS" : "FAIL");
    }
    printf("===== Done =====\n\n");

    // ---- Sobel 边缘检测自检（K=3, C=1, OC=2；权重在 ROM 的 W_BASE_SOBEL 段）----
    printf("===== Sobel Edge Selftest (K=3, OC=2) =====\n");
    {
        static const int8_t sob_in[64] = {
             0,  0,  0,  0,  0,  0,-30,-30,
             0,  0,  0,  0,  0,  0,-30,-30,
             0,  0, 30, 30, 30, 30,  0,  0,
             0,  0, 30, 30, 30, 30,  0,  0,
             0,  0, 30, 30, 30, 30,  0,  0,
             0,  0, 30, 30, 30, 30,  0,  0,
             0,  0,  0,  0,  0,  0,  0,  0,
             0,  0,  0,  0,  0,  0,  0,  0
        };
        static const int32_t sob_b[2] = { 0, 0 };
        int8_t gx[36], gy[36];
        int nz = 0, gx_mid0 = 1, gy_mid0 = 1, r, c;

        cnn_clear_ptrs();
        cnn_set_wbase(W_BASE_SOBEL);
        cnn_config(8, 8, 1, 3, 2, 1, 0, 0, 0);   /* H=8 W=8 C=1 K=3 OC=2 S=1 SHIFT=0 RELU=0 */
        cnn_load_input(sob_in, 64);
        cnn_load_bias(sob_b, 2);
        cnn_run();

        for (r = 0; r < 36; r++) {
            gx[r] = cnn_read_output((uint32_t)(r * 2 + 0));   /* oc0 = Gx */
            gy[r] = cnn_read_output((uint32_t)(r * 2 + 1));   /* oc1 = Gy */
        }

        printf("  Gx (vertical edges, 6x6):\n");
        for (r = 0; r < 6; r++) {
            printf("   ");
            for (c = 0; c < 6; c++) printf("%5d", (int)gx[r * 6 + c]);
            printf("\n");
        }
        printf("  Gy (horizontal edges, 6x6):\n");
        for (r = 0; r < 6; r++) {
            printf("   ");
            for (c = 0; c < 6; c++) printf("%5d", (int)gy[r * 6 + c]);
            printf("\n");
        }

        for (r = 0; r < 36; r++) {
            if (gx[r] != 0) nz++;
            if (gy[r] != 0) nz++;
        }
        for (r = 0; r < 6; r++)                 /* 方块内部：Gx 中两列应为 0 */
            if (gx[r * 6 + 2] != 0 || gx[r * 6 + 3] != 0) gx_mid0 = 0;
        for (c = 0; c < 6; c++)                 /* 方块内部：Gy 中两行应为 0 */
            if (gy[2 * 6 + c] != 0 || gy[3 * 6 + c] != 0) gy_mid0 = 0;

        printf("  nonzero = %d (expect 48)  Gx-mid-cols-zero = %d  Gy-mid-rows-zero = %d\n",
               nz, gx_mid0, gy_mid0);
        printf("SOBEL SELFTEST: %s\n",
               (nz == 48 && gx_mid0 && gy_mid0) ? "PASS" : "FAIL");
    }
    printf("===== Sobel Done =====\n\n");

    // ---- Sobel 边缘检测自检（K=3, C=1, OC=2；权重在 ROM 的 W_BASE_SOBEL 段）----
    printf("===== Sobel Edge Selftest (K=3, OC=2) =====\n");
    {
        static const int8_t sob_in[64] = {
             0,  0,  0,  0,  0,  0,-30,-30,
             0,  0,  0,  0,  0,  0,-30,-30,
             0,  0, 30, 30, 30, 30,  0,  0,
             0,  0, 30, 30, 30, 30,  0,  0,
             0,  0, 30, 30, 30, 30,  0,  0,
             0,  0, 30, 30, 30, 30,  0,  0,
             0,  0,  0,  0,  0,  0,  0,  0,
             0,  0,  0,  0,  0,  0,  0,  0
        };
        static const int32_t sob_b[2] = { 0, 0 };
        int8_t gx[36], gy[36];
        int nz = 0, gx_mid0 = 1, gy_mid0 = 1, r, c;

        cnn_clear_ptrs();
        cnn_set_wbase(W_BASE_SOBEL);
        cnn_config(8, 8, 1, 3, 2, 1, 0, 0, 0);   /* H=8 W=8 C=1 K=3 OC=2 S=1 SHIFT=0 RELU=0 */
        cnn_load_input(sob_in, 64);
        cnn_load_bias(sob_b, 2);
        cnn_run();

        for (r = 0; r < 36; r++) {
            gx[r] = cnn_read_output((uint32_t)(r * 2 + 0));   /* oc0 = Gx */
            gy[r] = cnn_read_output((uint32_t)(r * 2 + 1));   /* oc1 = Gy */
        }

        printf("  Gx (vertical edges, 6x6):\n");
        for (r = 0; r < 6; r++) {
            printf("   ");
            for (c = 0; c < 6; c++) printf("%5d", (int)gx[r * 6 + c]);
            printf("\n");
        }
        printf("  Gy (horizontal edges, 6x6):\n");
        for (r = 0; r < 6; r++) {
            printf("   ");
            for (c = 0; c < 6; c++) printf("%5d", (int)gy[r * 6 + c]);
            printf("\n");
        }

        for (r = 0; r < 36; r++) {
            if (gx[r] != 0) nz++;
            if (gy[r] != 0) nz++;
        }
        for (r = 0; r < 6; r++)                 /* 方块内部：Gx 中两列应为 0 */
            if (gx[r * 6 + 2] != 0 || gx[r * 6 + 3] != 0) gx_mid0 = 0;
        for (c = 0; c < 6; c++)                 /* 方块内部：Gy 中两行应为 0 */
            if (gy[2 * 6 + c] != 0 || gy[3 * 6 + c] != 0) gy_mid0 = 0;

        printf("  nonzero = %d (expect 48)  Gx-mid-cols-zero = %d  Gy-mid-rows-zero = %d\n",
               nz, gx_mid0, gy_mid0);
        printf("SOBEL SELFTEST: %s\n",
               (nz == 48 && gx_mid0 && gy_mid0) ? "PASS" : "FAIL");
    }
    printf("===== Sobel Done =====\n\n");

    while (1);
    return 0;
}
