NCabbage/e203_cnn/py/lenet_c5_split.h

// C5 split for W_DEPTH=8192
#ifndef LENET_C5_SPLIT_H
#define LENET_C5_SPLIT_H

#include <stdint.h>

static const int8_t c5a_weight_hw[8192] = {
       0,  -22,    8,   10,   16,  -25,    8,    3,   -1,   22,   -3,    6,  -18,   -3,   -7,   -6,
      24,  -19,    1,  -21,    3,  -20,  -13,    2,    1,   -3,  -26,  -13,  -17,  -10,   -5,  -35,
     -15,  -14,  -14,   -2,   22,   14,  -14,    1,    6,   66,  -31,  -40,  -14,   43,  -15,   -9,
      17,   -7,  -47,    9,  -15,  -22,   12,    1,  -33,  -31,  -38,    5,   40,  -12,  -52,  -62,
       1,    6,   -5,   -1,   13,   10,   -9,   11,   19,   23,    7,   -3,    3,   18,   26,  -12,
       6,  -29,  -13,   28,    2,    6,    7,    0,  -26,   -5,   16,   -8,    3,    8,  -30,   -3,
      -3,    8,   -9,  -31,  -30,  -18,  -45,   -2,    0,  -46,   14,  -10,   21,   15,  -16,   -2,
     -28,  -33,   15,  -70,   -1,  -11,    0,   -6,   23,   35,   -5,  -12,  -17,    2,   38,  -39,
       4,  -17,    2,    4,   29,  -64,  -10,    4,   -8,    7,  -10,  -10,    8,  -10,   -2,  -14,
      35,   -9,   67,  -23,  -13,  -33,    6,   13,    6,   20,   -1,   -1,  -48,  -10,    2,  -39,
       6,  -17,   -6,    0,   -9,  -27,  -27,  -10,    6,  -23,   -9,   -1,   15,  -39,  -18,  -16,
      22,  -11,  -50,  -10,   -8,    3,  -10,  -20,  -49,  -24,   22,  -30,  -37,   11,   15,   -7,
      -1,  -17,  -20,  -25,   27,  -36,   -6,  -13,   15,   -1,   33,    9,  -33,   21,   33,    7,
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
          10,       -9,        2,        5,      -11,        4,        2,       -5,
           6,       -2,        0,       -4,        4,       10,       -8,       -4,
          -6,        0,        9,       -2,        2,        2,      -13,       -5,
};

#endif
