NCabbage/e203_cnn/(commit log)

2026-09-26 feat: 上传rtl源码，忽略prj工程文件夹
2026-09-29 chore: 清理仓库，仅保留rtl源码目录
2026-09-29 feat: 修改xxx模块代码
2026-09-29 删除测试文档
2026-10-03 feat: 新增 INT8 CNN 加速器 RTL(cnn_top/cnn_quant/cnn_mac/cnn_regs)，mems.v 由 regfile 换为 cnn_regs
2026-10-05 v1.0冻结
2026-10-07 feat: 完成W4 LeNet驱动移植与F6分块修复
2026-10-07 Revert "feat: 完成W4 LeNet驱动移植与F6分块修复"
    This reverts commit 82cbb003622dda4b4dabaf390e1d0ac4707874af.
    [main.c]
2026-10-08 测试基线与其他数据
2026-10-09 feat: 新增 CNN 加速器侧 PMU 性能监测单元
2026-10-09 权重放到BRAM
2026-10-09 合并文件 完成权重放到BRAM功能
2026-10-11 feat: 新增LeNet INT8黄金定点模型和逐层比对工具
2026-10-11 fix: 合并A侧权重BRAM版本并解决PMU/WBASE冲突
2026-10-12 fix: 修正BRAM权重预取时序并新增PMU日志解析工具
    - rtl/cnn/cnn_top.v: 权重预取 (tcnt+4)>>2 改为 (tcnt+8)>>2；BRAM同步读比原w_mem多一拍，不修则C3/C5等多输出通道层权重错位，A侧必须同步
    - LeNet_oneP/include/cnn.h: 新增 CNN_PMU_* 寄存器宏 (0x34-0x50)
    - LeNet_oneP/application/main.c: 推理前清PMU计数并打印PMU行；CSR改为运行前后差值口径
    - python/pmu/: 新增PMU/CSR日志解析脚本，支持串口/JTAG/人工表格三种输入，自动生成CSV、Markdown报告与饼图对比图
2026-10-12 docs: 新增 docs/ 协作目录（同步说明+移植方式）并统一 A/B 命名
    - docs/README.md: 命名约定(A=征服者7020/AX7020, B=PYNQ-Z2)、共用区与板专属区规则、一次同步的标准流程
    - docs/porting/: 双板差异规范(修订A/B命名)、桥接进B侧工程、移植到A侧的步骤与接口契约
    - docs/sync/: 本次同步说明(659f40d)
    - docs/reports/: 任务6 PMU日志解析与权重BRAM优化前后对比
    - README.md: 补充协作索引，指引到 docs/
    已知待处理: rtl/aic_rv32.v 是 AX7020 顶层却位于共用 rtl/ 下，建议挪到 board/ax7020/
2026-10-15 feat: 新增 2x2 max pooling 支持（收尾加餐①）
    - rtl/cnn/cnn_top.v: 新增 cfg_pool 端口；MAC 处 max/累加二选一；池化模式 bias 置 0、acc 初值 -128
    - rtl/cnn/cnn_regs.v: 新增 cfg_pool 寄存器，映射 CFG1[20]；注意本文件与 cnn_top.v 必须成对同步，否则端口不匹配
    - python/golden/export_hex.py: 新增 maxpool2d_int8() 与 t8_pool 用例
    - LeNet_oneP/application/main.c: 新增池化上板自检段
    - docs/: 新增池化交付文档与同步说明
    验证：单元回归 7 PASS/0 FAIL；上板 POOL SELFTEST PASS(9/9 含负数窗口)；W3 联合验证 PASS；时序 WNS 0.000/WHS 0.028；资源 +98 LUT/+8 FF，BRAM/DSP 不变；cfg_pool=0 时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
2026-10-16 feat: 新增 FC(1x1卷积) 复用与 Sobel 边缘检测（收尾加餐④）
    - rtl/cnn/cnn_top.v / cnn_regs.v: W_TOTAL_WORDS 11060 -> 11066（追加 Sobel 段）
    - python/golden/export_wbase_tap.py: 新增 pack_sobel()，SOBEL_BASE=11060
    - python/golden/rom_all_tap.hex: 末尾追加 Gx/Gy 两个 3x3 核（6 字，11066 行）
    - python/golden/export_hex.py: 新增 t9_fc（FC=1x1 卷积等价性）与 t10_sobel 用例
    - LeNet_oneP: wbase_tap.h 加 W_BASE_SOBEL；main.c 加 Sobel 上板自检
    - docs/: 交付文档与同步说明
    验证：单元回归 9 PASS/0 FAIL；Sobel 上板 6x6x2 与黄金模型逐点一致(nonzero=48)；池化与 LeNet 未受影响；时序 WNS 0.000/WHS 0.028
    重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
2026-10-17 修改合并准确率98%
2026-10-30 fix(repro): complete chapter 8 validation and board-compatible batch flow
    - preserve 11060 LeNet ROM words and append 6 Sobel words
    - keep PMU_WLOAD at zero after ROM integration
    - add forced ROM rebuild, simulation and board programming scripts
    - add ACK/retry UART batch mode while preserving the original RUN protocol
    - document PYNQ-Z2 reproduction results and AX7020 porting steps
2026-10-30 chore: make Vivado 2025.2 PYNQ-Z2 the reference baseline
    - standardize the ROM IP outputs to Vivado 2025.2 / BMG rev12
    - use the validated 57600 baud batch configuration by default
    - document PYNQ-Z2 as authoritative and other boards as downstream adaptations
2026-11-02 feat: add real-board live demo dashboard
